frederic-salach/PKR251-Vacuum-Meter/analog board/analog board layout.png

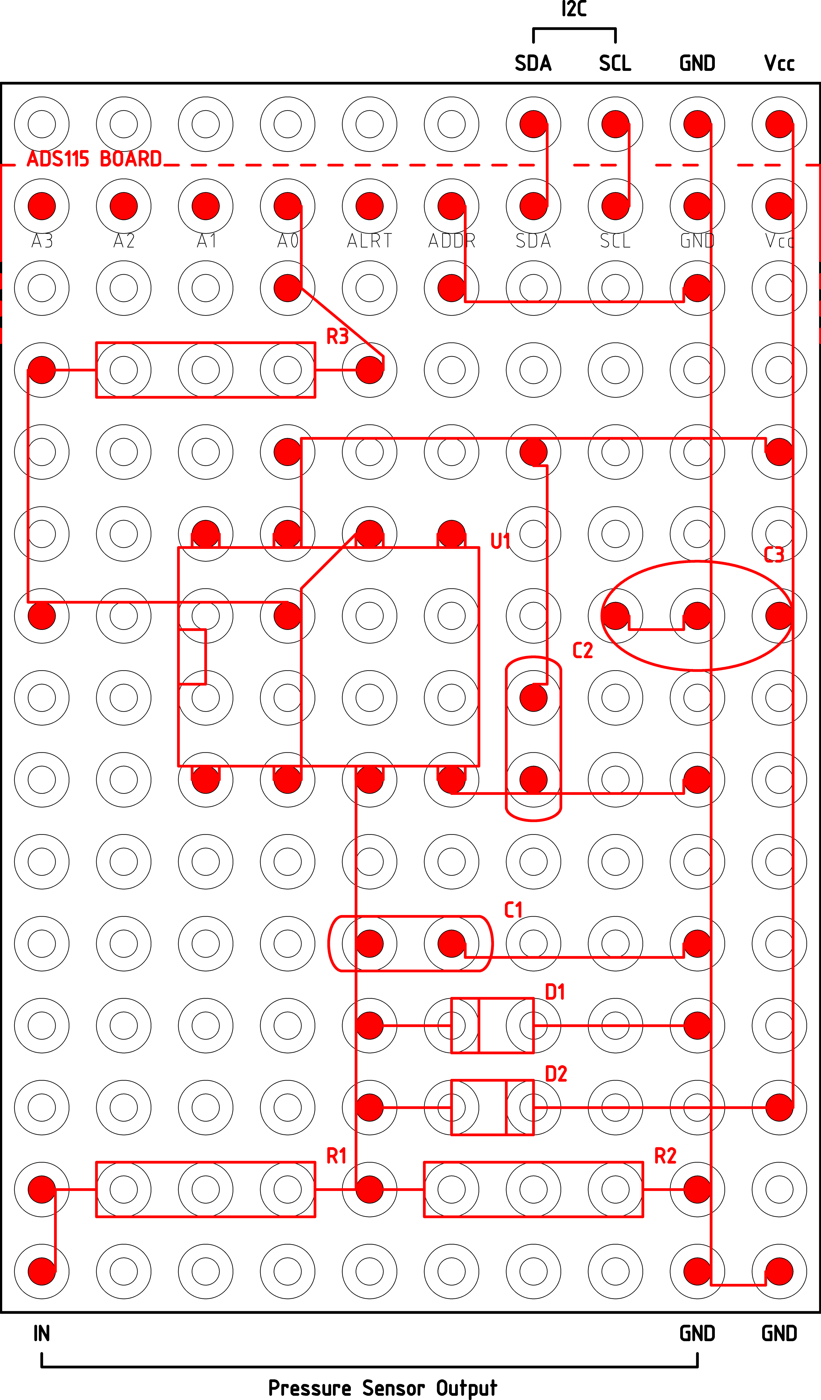
analog board/analog board layout.png
