frederic-salach/PKR251-Vacuum-Meter/vacuum meter block diagram.png

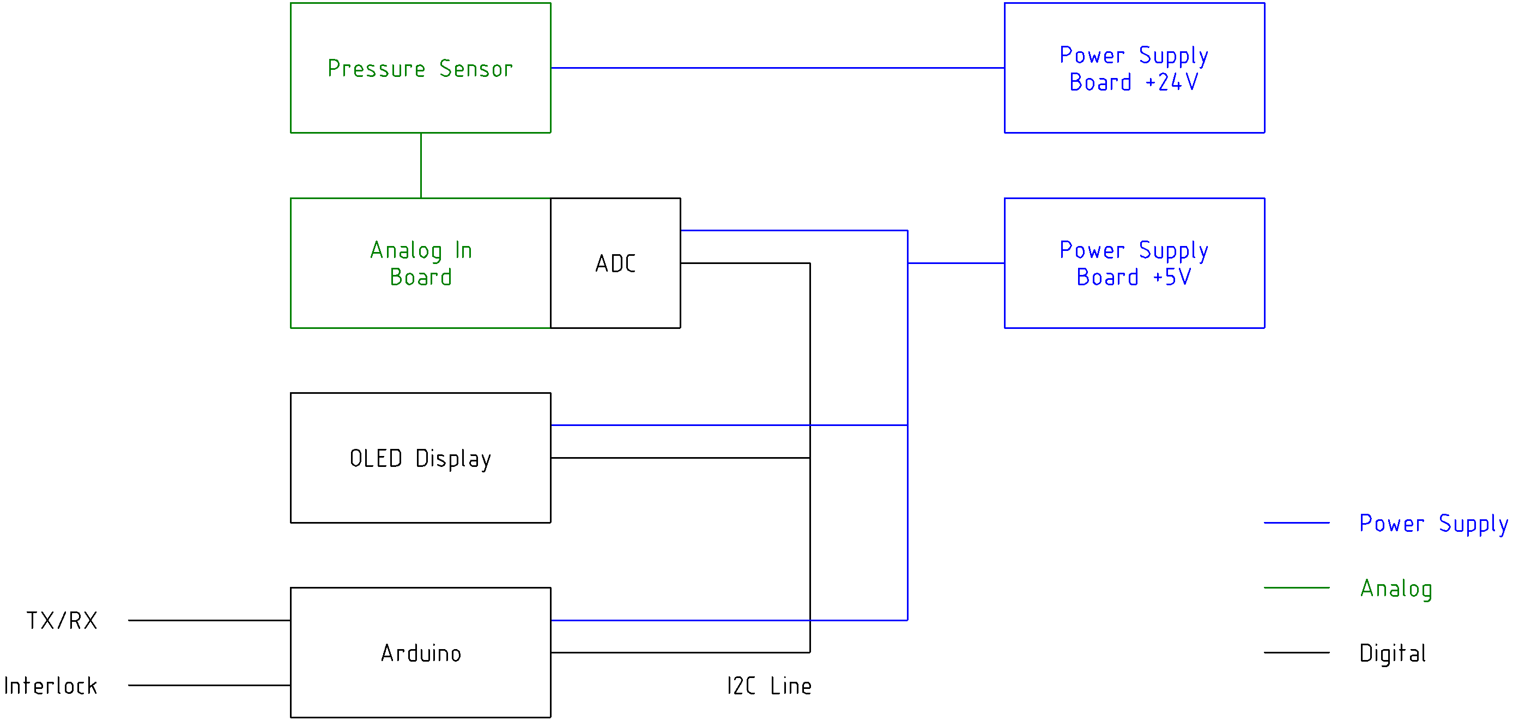
vacuum meter block diagram.png
