frederic-salach/PKR251-Vacuum-Meter/analog board/analog board layout.dxf

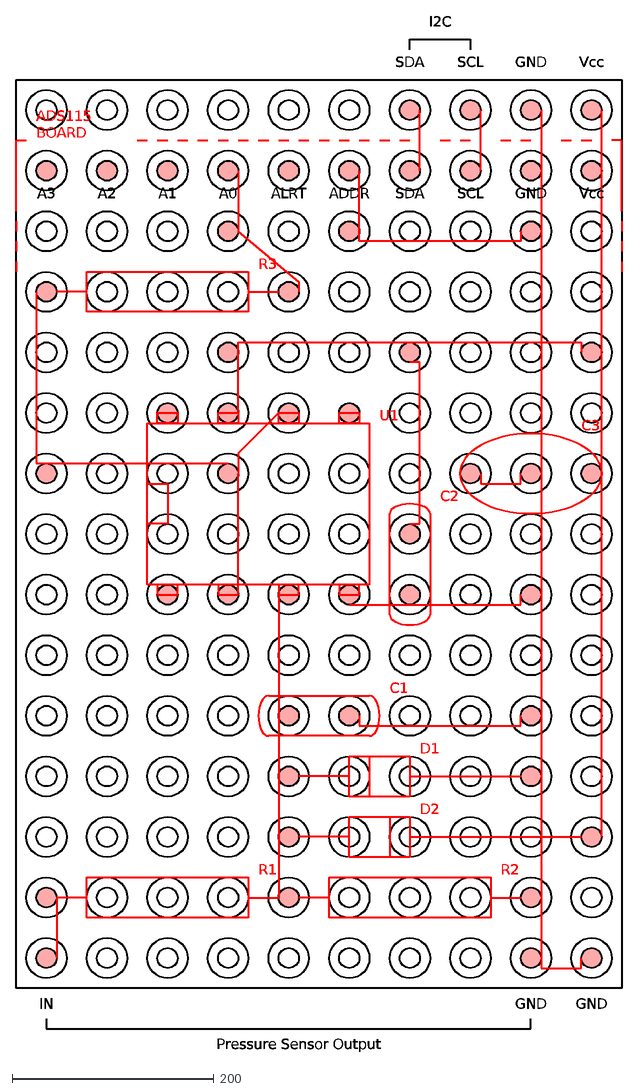
[picture p3: CAD file, 2023-10-29]
analog board/analog board layout.dxf
D2
D1
R2
R1
U1
R3
ADS115 BOARD
Vcc
GND
SCL
SDA
ADDR
ALRT
A0
A1
A2
A3
C2
C1
C3
I2C
IN
Pressure Sensor Output
