frederic-salach/PKR251-Vacuum-Meter/vacuum meter block diagram.dxf

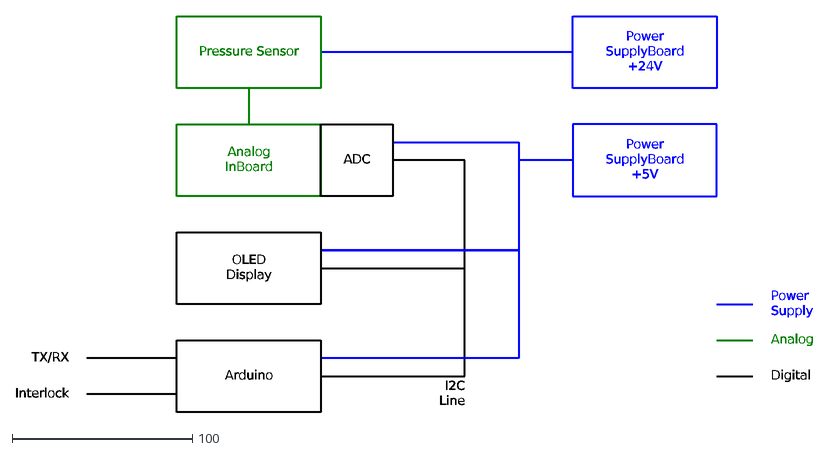
[picture p4: CAD file, 2023-10-29]
vacuum meter block diagram.dxf
Analog In Board
Pressure Sensor
Digital
Analog
Power Supply
ADC
OLED Display
Arduino
Power Supply Board +24V
Power Supply Board +5V
I2C Line
TX/RX
Interlock
