frederic-salach/PKR251-Vacuum-Meter/analog board/LTSpice/Analog_In_Board circuit.pdf

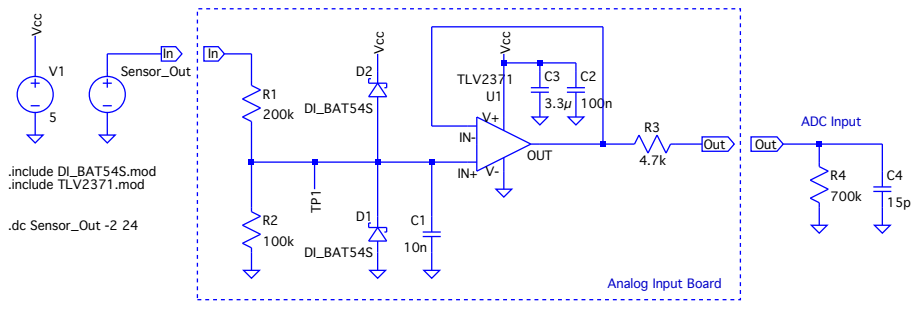
[picture p5: page 1]

.include TLV2371.mod .dc Sensor_Out -2 24 .include DI_BAT54S.mo
