frederic-salach/PKR251-Vacuum-Meter/analog board/LTSpice/Analog_In_Board dc error.pdf

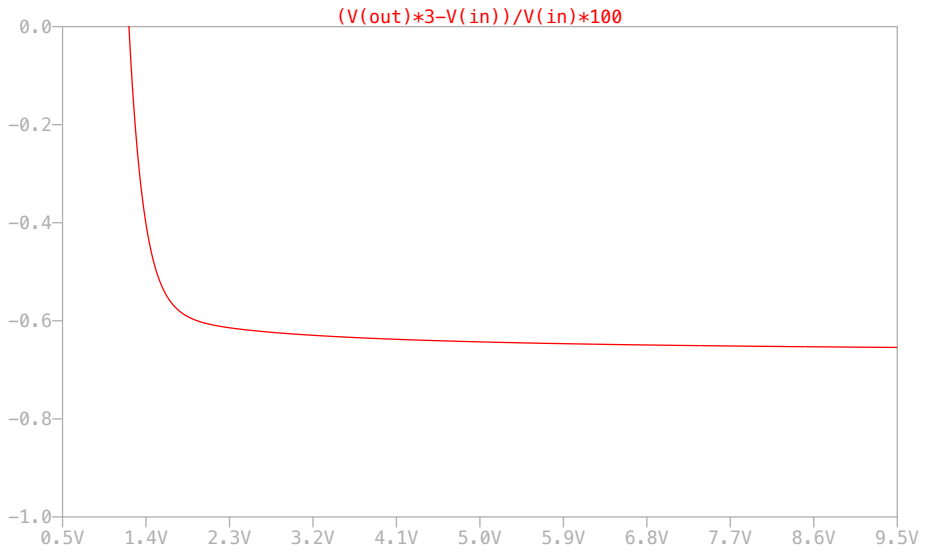
[picture p6: page 1]
