frederic-salach/PKR251-Vacuum-Meter/analog board/LTSpice/Analog_In_Board dc out.pdf

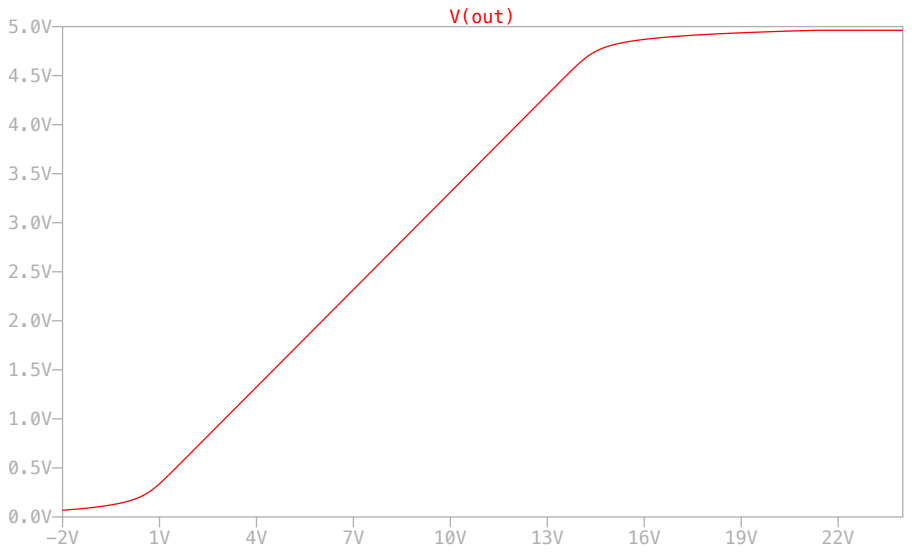
[picture p7: page 1]
