frederic-salach/PKR251-Vacuum-Meter/analog board/LTSpice/Analog_In_Board dc TP1.pdf

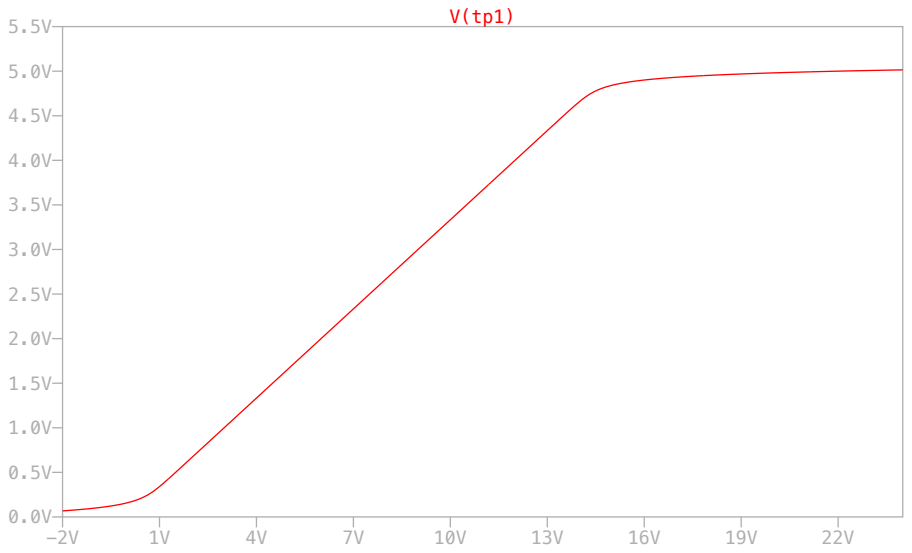
[picture p8: page 1]
