frederic-salach/PKR251-Vacuum-Meter/analog board/LTSpice/Analog_In_Board.asc

C1: cap; 10n
C2: cap; 100n
C3: cap; 3.3µ
C4: cap; 15p
D1: schottky; DI_BAT54S
D2: schottky; DI_BAT54S
R1: res; 200k
R2: res; 100k
R3: res; 4.7k
R4: res; 700k
Sensor_Out: voltage; ""
U1: TLV2371
V1: voltage; 5
Named nets: 0, Vcc, Out, In, TP1
.include TLV2371.mod
.dc Sensor_Out 1.8 8.6
.include DI_BAT54S.mod
Analog Input Board
ADC Input
